Tdieney/VCU_Cluster_System/hardware/README.md

## Design case via Fusion360

<p align="center">
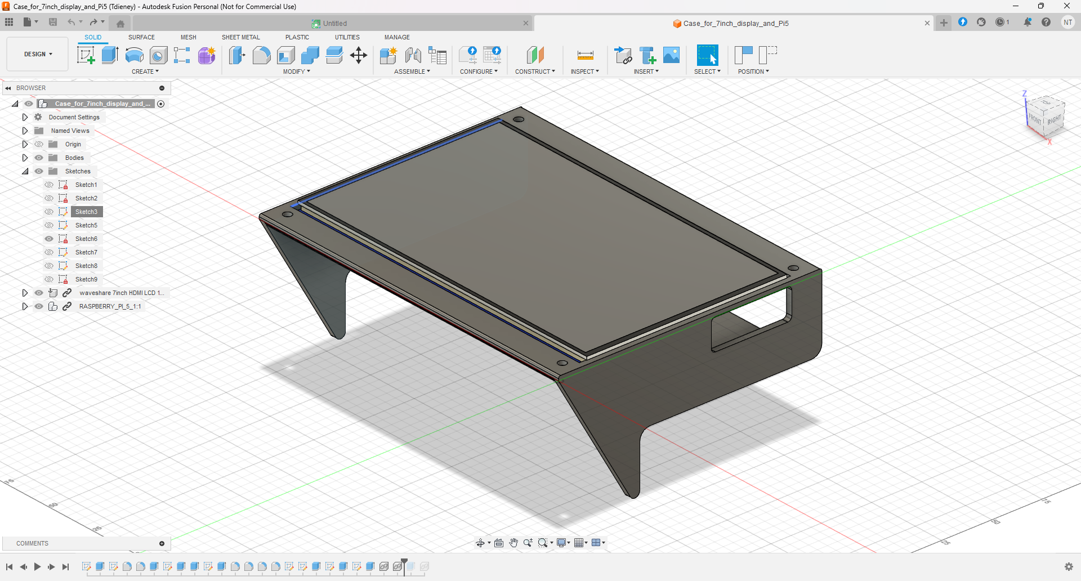
[picture p3: hardware/img/img2.png]
    
</p>

<p align="center">
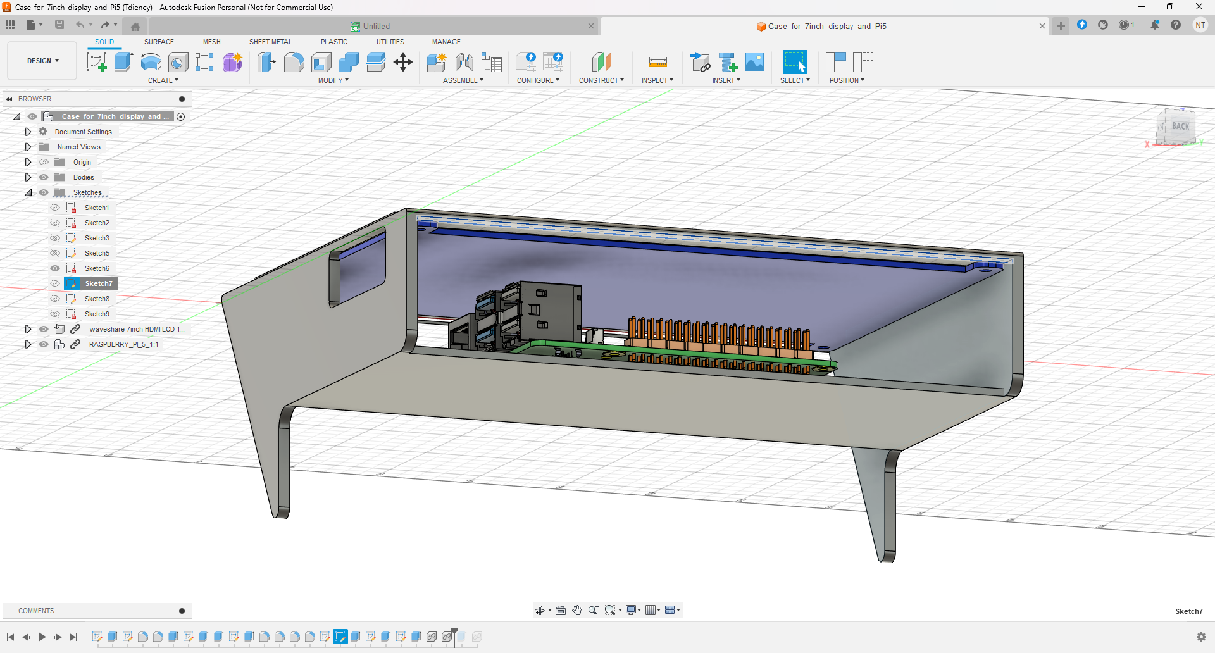
[picture p4: hardware/img/img1.png]
    
</p>

## Real image

<p align="center">
    
</p>
