Tdieney/VCU_Cluster_System/software/qtapp/files/images/arrow.png

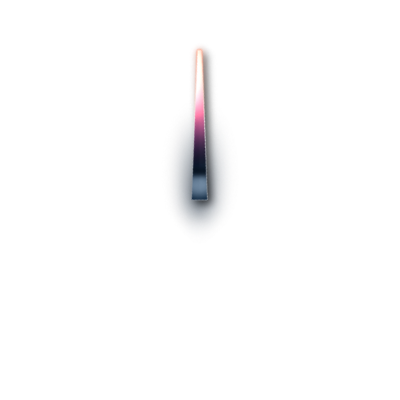
software/qtapp/files/images/arrow.png
