Tdieney/VCU_Cluster_System/software/qtapp/files/images/background1.png

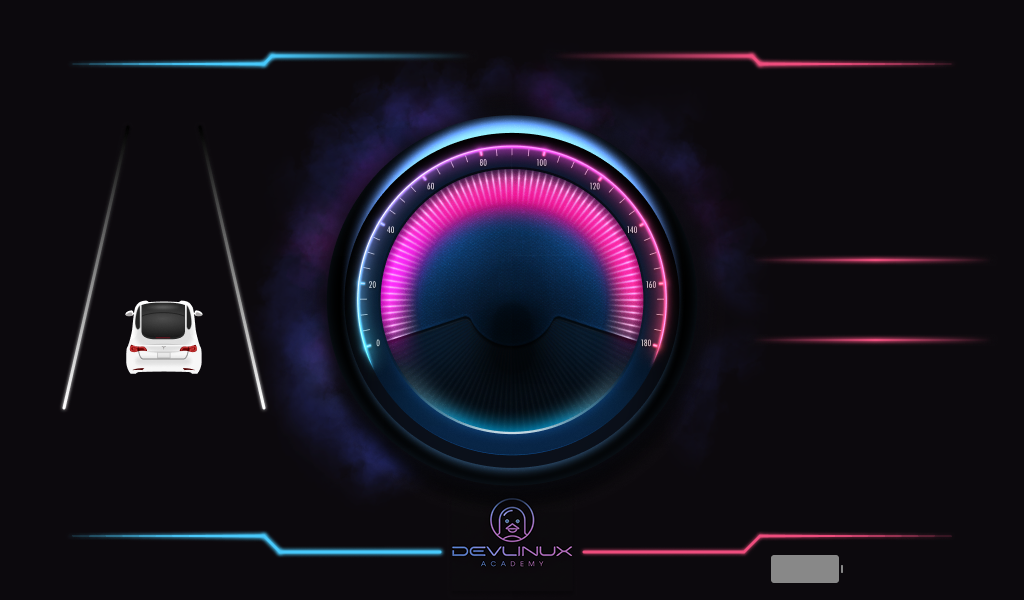
software/qtapp/files/images/background1.png
