Tdieney/VCU_Cluster_System/hardware/Case_for_7inch_display_and_Pi5.stl

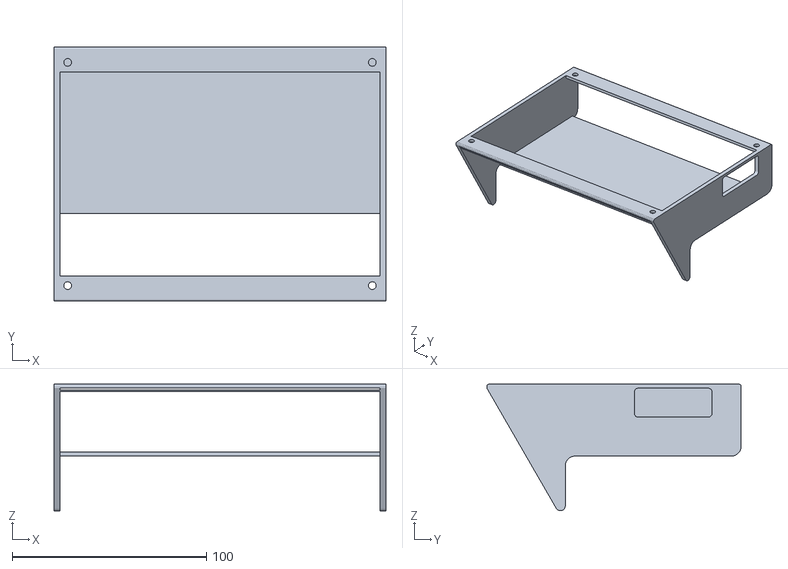
[picture p19: CAD file, 2025-07-08]
hardware/Case_for_7inch_display_and_Pi5.stl
171.0 x 131.0 x 65.2
