Tdieney/VCU_Cluster_System/ecu_nodes/stm32f1_ecu_nodes/Core/Src/main.c

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
/* Includes ------------------------------------------------------------------*/
#include "main.h"
#include "cmsis_os.h"

/* USER CODE BEGIN Includes */
#include "button.h"
#include "can.h"
#include <stdbool.h>
#include <string.h>
/* USER CODE END Includes */

ADC_HandleTypeDef hadc1;
DMA_HandleTypeDef hdma_adc1;

CAN_HandleTypeDef hcan;

TIM_HandleTypeDef htim1;
TIM_HandleTypeDef htim3;

/* Definitions for CANRxHandlerTask */
osThreadId_t CANRxHandlerTaskHandle;
const osThreadAttr_t CANRxHandlerTask_attributes = {
  .name = "CANRxHandlerTask",
  .stack_size = 128 * 4,
  .priority = (osPriority_t) osPriorityNormal,
};
/* Definitions for CANTxHandlerTask */
osThreadId_t CANTxHandlerTaskHandle;
const osThreadAttr_t CANTxHandlerTask_attributes = {
  .name = "CANTxHandlerTask",
  .stack_size = 128 * 4,
  .priority = (osPriority_t) osPriorityNormal,
};
/* USER CODE BEGIN PV */
uint16_t potentiometer[TEN] = {0};

CAN_Frame canTxQueue[CAN_TX_QUEUE_SIZE];

volatile DigitalOutput_Resp_Frame digital_output_data[NUMBER_OF_DIG_OUT_RES_FRAME] = {0};
volatile DigitalInput_Resp_Frame digital_input_data[NUMBER_OF_DIG_IN_RES_FRAME] = {0};
volatile DigitalOutput_Cmd_Frame digital_output_cmd_data[NUMBER_OF_DIG_OUT_CMD_FRAME] = {0};
volatile AnalogInput_Resp_Frame analog_input_data[NUMBER_OF_ANALOG_IN_RES_FRAME] = {0};

CAN_RxFrame can_rx_frame;

/* USER CODE END PV */

void SystemClock_Config(void);
static void MX_GPIO_Init(void);
static void MX_DMA_Init(void);
static void MX_CAN_Init(void);
static void MX_ADC1_Init(void);
static void MX_TIM1_Init(void);
static void MX_TIM3_Init(void);
void CANRxHandler(void *argument);
void CANTxHandler(void *argument);

/* USER CODE BEGIN PFP */
/**
  * @brief  Process Digital Output Commands
  * @param  cmd_data: Pointer to the Digital Output Command Frame
  *                                   containing the commands to process
  * @retval None
  */
void digital_output_process(DigitalOutput_Cmd_Frame *cmd_data);

/* USER CODE END PFP */

/* USER CODE BEGIN 0 */
void HAL_CAN_RxFifo0MsgPendingCallback(CAN_HandleTypeDef *hcan) {
  HAL_CAN_GetRxMessage(hcan, CAN_RX_FIFO0, &can_rx_frame.header, can_rx_frame.data);
  // Process received CAN message
  CAN_process_command(&can_rx_frame, digital_output_cmd_data);
}

/* USER CODE END 0 */

/**
  * @brief  The application entry point.
  * @retval int
  */
int main(void)
{
  /* MCU Configuration--------------------------------------------------------*/

  /* Reset of all peripherals, Initializes the Flash interface and the Systick. */
  HAL_Init();

  /* Configure the system clock */
  SystemClock_Config();

  /* Initialize all configured peripherals */
  MX_GPIO_Init();
  MX_DMA_Init();
  MX_CAN_Init();
  MX_ADC1_Init();
  MX_TIM1_Init();
  MX_TIM3_Init();
  /* USER CODE BEGIN 2 */
  HAL_TIM_PWM_Start(&htim1, TIM_CHANNEL_1);
  HAL_TIM_PWM_Start(&htim1, TIM_CHANNEL_2);
  HAL_TIM_PWM_Start(&htim1, TIM_CHANNEL_3);
  HAL_TIM_PWM_Start(&htim1, TIM_CHANNEL_4);
  HAL_TIM_PWM_Start(&htim3, TIM_CHANNEL_1);
  HAL_TIM_PWM_Start(&htim3, TIM_CHANNEL_2);
  HAL_TIM_PWM_Start(&htim3, TIM_CHANNEL_3);
  HAL_TIM_PWM_Start(&htim3, TIM_CHANNEL_4);

  HAL_CAN_Start(&hcan);
  HAL_CAN_ActivateNotification(&hcan, CAN_IT_RX_FIFO0_MSG_PENDING);

  HAL_ADC_Start_DMA(&hadc1, (uint32_t *)potentiometer, TEN);

  /* USER CODE END 2 */

  /* Init scheduler */
  osKernelInitialize();

  /* USER CODE BEGIN RTOS_MUTEX */
  /* add mutexes, ... */
  /* USER CODE END RTOS_MUTEX */

  /* USER CODE BEGIN RTOS_SEMAPHORES */
  /* add semaphores, ... */
  /* USER CODE END RTOS_SEMAPHORES */

  /* USER CODE BEGIN RTOS_TIMERS */
  /* start timers, add new ones, ... */
  /* USER CODE END RTOS_TIMERS */

  /* USER CODE BEGIN RTOS_QUEUES */
  /* add queues, ... */
  /* USER CODE END RTOS_QUEUES */

  /* Create the thread(s) */
  /* creation of CANRxHandlerTask */
  CANRxHandlerTaskHandle = osThreadNew(CANRxHandler, NULL, &CANRxHandlerTask_attributes);

  /* creation of CANTxHandlerTask */
  CANTxHandlerTaskHandle = osThreadNew(CANTxHandler, NULL, &CANTxHandlerTask_attributes);

  /* USER CODE BEGIN RTOS_THREADS */
  /* add threads, ... */
  /* USER CODE END RTOS_THREADS */

  /* USER CODE BEGIN RTOS_EVENTS */
  /* add events, ... */
  /* USER CODE END RTOS_EVENTS */

  /* Start scheduler */
  osKernelStart();

  /* We should never get here as control is now taken by the scheduler */
  /* Infinite loop */
  /* USER CODE BEGIN WHILE */
  while (1)
  {
    /* USER CODE END WHILE */

    /* USER CODE BEGIN 3 */
  }
  /* USER CODE END 3 */
}

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
/* USER CODE BEGIN 4 */
/**
  * @brief  Process Digital Output Commands
  * @param  cmd_data: Pointer to the Digital Output Command Frame
  *                                   containing the commands to process
  * @retval None
  */
void digital_output_process(DigitalOutput_Cmd_Frame *cmd_data) {
  // Digital Output 1
  if (cmd_data[0].signal[0].switchCmd == 1) {
    TIM1->CCR4 = (cmd_data[0].signal[0].dutyCycle * 10U) - 1U;
  } else {
    TIM1->CCR4 = 0;
  }

  // Digital Output 10
  if (cmd_data[1].signal[1].switchCmd == 1) {
    TIM1->CCR3 = (cmd_data[1].signal[1].dutyCycle * 10U) - 1U;
  } else {
    TIM1->CCR3 = 0;
  }

  // Digital Output 19
  if (cmd_data[2].signal[2].switchCmd == 1) {
    TIM1->CCR2 = (cmd_data[2].signal[2].dutyCycle * 10U) - 1U;
  } else {
    TIM1->CCR2 = 0;
  }

  // Digital Output 28
  if (cmd_data[3].signal[3].switchCmd == 1) {
    TIM1->CCR1 = (cmd_data[3].signal[3].dutyCycle * 10U) - 1U;
  } else {
    TIM1->CCR1 = 0;
  }

  // Digital Output 8
  // if (cmd_data[0].signal[7].switchCmd == 1) {
  //   TIM3->CCR1 = (cmd_data[0].signal[7].dutyCycle * 10U) - 1U;
  // } else {
  //   TIM3->CCR1 = 0;
  // }

  // Digital Output 12
  if (cmd_data[1].signal[3].switchCmd == 1) {
    TIM3->CCR2 = (cmd_data[1].signal[3].dutyCycle * 10U) - 1U;
  } else {
    TIM3->CCR2 = 0;
  }

  // Digital Output 22
  if (cmd_data[2].signal[5].switchCmd == 1) {
    TIM3->CCR3 = (cmd_data[2].signal[5].dutyCycle * 10U) - 1U;
  } else {
    TIM3->CCR3 = 0;
  }

  // Digital Output 32
  if (cmd_data[3].signal[7].switchCmd == 1) {
    TIM3->CCR4 = (cmd_data[3].signal[7].dutyCycle * 10U) - 1U;
  } else {
    TIM3->CCR4 = 0;
  }
}
/* USER CODE END 4 */

/* USER CODE BEGIN Header_CANRxHandler */
/**
  * @brief  Function implementing the CANRxHandlerTask thread.
  * @param  argument: Not used
  * @retval None
  */
/* USER CODE END Header_CANRxHandler */
void CANRxHandler(void *argument)
{
  /* USER CODE BEGIN 5 */
  
  btn_matrix_init();
  TIM3->CCR1 = 999; // Initialize PWM duty cycle to 999
  /* Infinite loop */
  for(;;)
  {
    // Process button matrix input
    btn_matrix_process(digital_input_data);
    // Process Digital Output Commands immediately
    digital_output_process(digital_output_cmd_data);

  }
  /* USER CODE END 5 */
}

/* USER CODE BEGIN Header_CANTxHandler */
/**
* @brief Function implementing the CANTxHandlerTask thread.
* @param argument: Not used
* @retval None
*/
/* USER CODE END Header_CANTxHandler */
void CANTxHandler(void *argument)
{
  /* USER CODE BEGIN CANTxHandler */

  // Initialize default values for Digital Output Response
  for (uint8_t i = 0; i < NUMBER_OF_DIG_OUT_RES_FRAME; i++) {
    for (uint8_t j = 0; j < DIGITAL_OUT_RESP_SIGNAL_PER_FRAME; j++) {
      digital_output_data[i].signal[j].statusPS = 0; // Off
      digital_output_data[i].signal[j].elDiagnosis = 0; // OK
      digital_output_data[i].signal[j].currentFB = 5; // 10mA
    }
  }

  // Initialize Digital Input Response Frame
  for (uint8_t i = 0; i < NUMBER_OF_DIG_IN_RES_FRAME; i++) {
    for (uint8_t j = 0; j < DIGITAL_IN_RESP_SIGNAL_PER_FRAME; j++) {
      digital_input_data[i].signal[j].inputStatus = 0; // Off
      digital_input_data[i].signal[j].freshness = 0;
      digital_input_data[i].signal[j].elDiagnosis = 0; // OK
    }
  }

  /* Infinite loop */
  for(;;)
  {
    CAN_Frame tx_frame;
    uint32_t potentiometer_value = 0;

    // Prepare Digital Output Response Frame
    for (uint8_t i = 0; i < NUMBER_OF_DIG_OUT_RES_FRAME; i++) {
      tx_frame.id = DIGITAL_OUTPUT_RES_ID(i);
      memcpy(tx_frame.data, &digital_output_data[i].sdu, sizeof(digital_output_data[i].sdu));
      CAN_EnqueueTxFrame(&tx_frame, canTxQueue);
    }

    // Prepare Digital Input Response Frame
    for (uint8_t i = 0; i < NUMBER_OF_DIG_IN_RES_FRAME; i++) {
      for (uint8_t j = 0; j < DIGITAL_IN_RESP_SIGNAL_PER_FRAME; j++) {
        digital_input_data[i].signal[j].freshness++;
      }
    }
    for (uint8_t i = 0; i < NUMBER_OF_DIG_IN_RES_FRAME; i++){
      tx_frame.id = DIGITAL_INPUT_RES_ID(i);
      memcpy(tx_frame.data, &digital_input_data[i].sdu, sizeof(digital_input_data[i].sdu));
      CAN_EnqueueTxFrame(&tx_frame, canTxQueue);
    }

    // Prepare Analog Input Response Frame
    for (uint8_t i = 0; i < TEN; i++) {
      potentiometer_value += potentiometer[i];
    }
    potentiometer_value /= TEN;
    analog_input_data[0].signal[0].analogValue = potentiometer_value;
    for (uint8_t i = 0; i < NUMBER_OF_ANALOG_IN_RES_FRAME; i++) {
      tx_frame.id = ANALOG_INPUT_RES_ID(i);
      memcpy(tx_frame.data, &analog_input_data[i].sdu, sizeof(analog_input_data[i].sdu));
      CAN_EnqueueTxFrame(&tx_frame, canTxQueue);
    }

    CAN_send(&hcan, canTxQueue);

    osDelay(50);
  }
  /* USER CODE END CANTxHandler */
}

 /**
  * @brief  Period elapsed callback in non blocking mode
  * @note   This function is called  when TIM4 interrupt took place, inside
  * HAL_TIM_IRQHandler(). It makes a direct call to HAL_IncTick() to increment
  * a global variable "uwTick" used as application time base.
  * @param  htim : TIM handle
  * @retval None
  */
void HAL_TIM_PeriodElapsedCallback(TIM_HandleTypeDef *htim)
{
  if (htim->Instance == TIM4) {
    HAL_IncTick();
  }
}

/**
  * @brief  This function is executed in case of error occurrence.
  * @retval None
  */
void Error_Handler(void)
{
  /* USER CODE BEGIN Error_Handler_Debug */
  /* User can add his own implementation to report the HAL error return state */
  __disable_irq();
  while (1)
  {
  }
  /* USER CODE END Error_Handler_Debug */
}

#ifdef  USE_FULL_ASSERT
/**
  * @brief  Reports the name of the source file and the source line number
  *         where the assert_param error has occurred.
  * @param  file: pointer to the source file name
  * @param  line: assert_param error line source number
  * @retval None
  */
void assert_failed(uint8_t *file, uint32_t line)
{
  /* USER CODE BEGIN 6 */
  /* User can add his own implementation to report the file name and line number,
     ex: printf("Wrong parameters value: file %s on line %d\r\n", file, line) */
  /* USER CODE END 6 */
}
#endif /* USE_FULL_ASSERT */

/************************ (C) COPYRIGHT STMicroelectronics *****END OF FILE****/
