Tdieney/VCU_Cluster_System/ecu_nodes/stm32f1_ecu_nodes/stm32f1_ecu_nodes.ioc

Mcu.UserName=STM32F103C8Tx
PB14.GPIO_Label=BTN_COL2
PA6.GPIO_Label=DIGITAL_OUT_8
PB0.GPIO_Label=DIGITAL_OUT_22
PB6.GPIO_Label=BTN_ROW2
PB13.GPIO_Label=BTN_COL1
PB13.Signal=GPIO_Output
PB15.Signal=GPIO_Output
PD1-OSC_OUT.Signal=RCC_OSC_OUT
PB6.Signal=GPXTI6
PB12.GPIO_Label=BTN_COL0
PB1.GPIO_Label=DIGITAL_OUT_32
PA10.GPIO_Label=DIGITAL_OUT_10
PB7.Signal=GPXTI7
PA8.Signal=S_TIM1_CH1
PB7.GPIO_Label=BTN_ROW3
PB9.Signal=CAN_TX
PB1.Signal=S_TIM3_CH4
PA6.Signal=S_TIM3_CH1
PA10.Signal=S_TIM1_CH3
PB5.GPIO_Label=BTN_ROW1
PB4.Signal=GPXTI4
PA9.GPIO_Label=DIGITAL_OUT_19
PC13-TAMPER-RTC.Signal=GPIO_Output
PA11.GPIO_Label=DIGITAL_OUT_1
PD0-OSC_IN.Signal=RCC_OSC_IN
PA13.Signal=SYS_JTMS-SWDIO
PA8.GPIO_Label=DIGITAL_OUT_28
PA9.Signal=S_TIM1_CH2
PB14.Signal=GPIO_Output
PA5.Signal=ADCx_IN5
PB4.GPIO_Label=BTN_ROW0
PB15.GPIO_Label=BTN_COL3
PB5.Signal=GPXTI5
PA7.GPIO_Label=DIGITAL_OUT_12
PA11.Signal=S_TIM1_CH4
PA14.Signal=SYS_JTCK-SWCLK
PB8.Signal=CAN_RX
PB0.Signal=S_TIM3_CH3
PB12.Signal=GPIO_Output
PA7.Signal=S_TIM3_CH2
