Tdieney/VCU_Cluster_System/ecu_nodes/stm32f1_ecu_nodes/Core/Inc/main.h

#define DIGITAL_OUT_8_Pin GPIO_PIN_6
#define DIGITAL_OUT_8_GPIO_Port GPIOA
#define DIGITAL_OUT_12_Pin GPIO_PIN_7
#define DIGITAL_OUT_12_GPIO_Port GPIOA
#define DIGITAL_OUT_22_Pin GPIO_PIN_0
#define DIGITAL_OUT_22_GPIO_Port GPIOB
#define DIGITAL_OUT_32_Pin GPIO_PIN_1
#define DIGITAL_OUT_32_GPIO_Port GPIOB
#define BTN_COL0_Pin GPIO_PIN_12
#define BTN_COL0_GPIO_Port GPIOB
#define BTN_COL1_Pin GPIO_PIN_13
#define BTN_COL1_GPIO_Port GPIOB
#define BTN_COL2_Pin GPIO_PIN_14
#define BTN_COL2_GPIO_Port GPIOB
#define BTN_COL3_Pin GPIO_PIN_15
#define BTN_COL3_GPIO_Port GPIOB
#define DIGITAL_OUT_28_Pin GPIO_PIN_8
#define DIGITAL_OUT_28_GPIO_Port GPIOA
#define DIGITAL_OUT_19_Pin GPIO_PIN_9
#define DIGITAL_OUT_19_GPIO_Port GPIOA
#define DIGITAL_OUT_10_Pin GPIO_PIN_10
#define DIGITAL_OUT_10_GPIO_Port GPIOA
#define DIGITAL_OUT_1_Pin GPIO_PIN_11
#define DIGITAL_OUT_1_GPIO_Port GPIOA
#define BTN_ROW0_Pin GPIO_PIN_4
#define BTN_ROW0_GPIO_Port GPIOB
#define BTN_ROW0_EXTI_IRQn EXTI4_IRQn
#define BTN_ROW1_Pin GPIO_PIN_5
#define BTN_ROW1_GPIO_Port GPIOB
#define BTN_ROW1_EXTI_IRQn EXTI9_5_IRQn
#define BTN_ROW2_Pin GPIO_PIN_6
#define BTN_ROW2_GPIO_Port GPIOB
#define BTN_ROW2_EXTI_IRQn EXTI9_5_IRQn
#define BTN_ROW3_Pin GPIO_PIN_7
#define BTN_ROW3_GPIO_Port GPIOB
#define BTN_ROW3_EXTI_IRQn EXTI9_5_IRQn
#define ZERO                    0U
#define ONE                     1U
#define TWO                     2U
#define THREE                   3U
#define FOUR                    4U
#define FIVE                    5U
#define SIX                     6U
#define SEVEN                   7U
#define EIGHT                   8U
#define NINE                    9U
#define TEN                     10U
