Tdieney/VCU_Cluster_System/(commit log)

2025-07-08 Update socketCAN reference link in README.md
2025-07-08 Create case for display and raspberry pi
    [Case_for_7inch_display_and_Pi5.stl]
2025-07-13 Initial code for ECU Nodes
    [stm32f1_ecu_nodes Debug.cfg]
2025-07-20 Fix the issue that Digital Output Cmd is stored in the same frame
    [can.c]
2025-07-20 Write PWM output for Digital Output Command
2025-08-08 Fix: handle multiple CAN frames without losing messages
    [main.c]
2025-08-11 Update UI and add logic for battery, trip, DTE
